WuWingKit/tree-whitewashing-robot/software/README.md

# 上位机与操作界面

底盘测试已提供无需安装的浏览器控制页，由S3托管，见[使用步骤](../firmware/remote_control/README.md)和[网页源码](../firmware/remote_control/esp32/RemoteControl/index.html)。

尚无完整视觉上位机、树干识别或覆盖率算法交付。几何假设与测距边界见[感知设计](../docs/05-perception.md)。
