WuWingKit/tree-whitewashing-robot/reports/2026-11-03/README.md

# 2026-11-03历史阶段汇报

[阶段进度与设计方案（背景配图版）](stage-progress-background-20261103.pptx)保留选题、概念设计和早期汇报内容。

**这是历史文件，不是最新BOM或接线依据。** 其中控制分工、超声波/红外等传感器、选型状态和部分参数可能早于后续采购变更。请以仓库首页、当前设计文档及2026-11-05采购表为准。历史PPT没有经过逐页更新，不应直接作为最终答辩定稿。

PPT含厂商展示图和网络背景图，仅作为原阶段汇报存档；图像不因此获得新的使用授权，见[第三方说明](../../THIRD_PARTY.md)。
