WuWingKit/tree-whitewashing-robot/docs/01-requirements.md

# 项目背景与需求

## 背景与工作范围

城市道路沿线树木的涂白作业需要沿树列逐棵进行。项目希望用移动底盘承载涂料、搅拌与环抱喷涂机构，通过自动识别、停车定位、环抱和垂直升降减少重复人工操作。节省材料、提高效率和减少人员接触属于项目目标，目前没有实测依据，不能宣称已经实现节能或环保收益。

现实设想是在辅道沿树列行进；当前只在自行搭建的缩比场景开展研究。实际道路的行人、路缘石、树池、坡度、路面不平、阳光和水尘条件不在首轮模型验证结论的覆盖范围内。

## 已确认的设计约束

|项目|当前状态|
|---|---|
|底盘|已采购双层大号亚克力四驱差速底盘，12V 320rpm编码器电机SKU|
|底盘尺寸|早期讨论275×192 mm；参考板照片230×305×5 mm。均不能代替当前整车实测轮廓，需测长宽、轮距和轴距|
|承载|用户预计2.5 kg；尚无整车承载试验，须明确是净载荷还是含整车总质量|
|机构位置|车身侧面、固定伸出长度；立柱从下层固定|
|夹爪尺寸|内径100、外径140、高50 mm，6孔；打印后净空另测|
|升降|拟选180 mm行程，17HS4401＋TB6600，尚未采购定型|
|树干模型|直径和间隔尚未定稿；不要求算法预先知道树间距或树径|
|行驶策略|沿树列总体向前，在每棵树前减速调整姿态并停车；不是行驶中喷涂|
|计算位置|电脑处理视觉和任务逻辑，车端完成实时执行与保护|

缩比应以当前实测底盘宽度/拟模拟实际车辆宽度定义比例，实车宽度1～2 m的讨论尚未给出唯一比例。树径、涂白高度、树池与间隔必须使用同一比例；夹爪100 mm和滑台180 mm还需要做空间兼容检查，不能称现有所有尺寸已经严格等比例。

## 首阶段目标与验收思路

完成受控场地内多棵模型树连续作业演示：识别下一棵树、逐步接近、停车并确认对中、检查作业范围、闭合环抱、搅拌供料并升降、停泵、评价可见涂白效果、打开后离开。

评估指标包括对中误差、有效测距率、单树作业时间、可见表面覆盖率、单位作业耗液量、通信丢帧与指令延迟、异常停机成功率。先采集基线再设合适阈值，当前不编造达标数据。

## 优先完成的范围

先完成普通差速底盘低速闭环和作业端近距定位；再解决未知树径下前向距离估计。先以清水检查喷淋和漏液，再用目标涂料验证流变与防堵。声光提示、显示界面和OTA保留接口，不能先于基本动作与断联停止验证。
