WuWingKit/tree-whitewashing-robot/docs/09-procurement.md

# 已采购产品与待选型清单

采购快照截至2026-11-05，依据用户提供的最新订单PDF逐项脱敏转录。已采购指已下单，不代表已收到、已装配或性能通过验收。订单号、账号、地址与支付凭据不进入公开仓库。

详见[机器可读已购表](../hardware/bom/purchased.csv)与[待选表](../hardware/bom/planned.csv)。单价与行金额按订单转录，折扣及四舍五入可能导致数量×显示单价不完全等于行金额。最终合计按行金额相加。

|产品|采购规格|数量|行金额/元|快照状态|
|---|---|---:|---:|---|
|电池及充电器|12V 5000mAh；DC公母头；配1A充电器|1|57.00|待发货|
|ST-LINK V2|进口芯片软件可升级；随机颜色|1|15.53|已发货|
|USB转TTL|CH340小板|1|5.63|已发货|
|USB Hub|灰色Type-C上行；USB3口+Type-C1口|1|10.00|待发货|
|ToF测距模块|TOF050C|3|34.46|已发货|
|USB摄像头|720P 90度无畸变|1|38.00|待发货|
|USB摄像头|720P 70度无畸变|1|36.00|待发货|
|ESP32-S3开发板|N16R8；Type-C；不焊针|1|28.51|已发货|
|STM32核心板|正点原子STM32F407ZGT6；不焊排针|1|88.00|待发货|
|杜邦线|30cm三款120根|1|10.66|已发货|
|杜邦线|15cm三款120根|1|8.21|已发货|
|杜邦线|21cm三款30根|1|4.70|已发货|
|四路电机驱动板|酷点TB6612带稳压4路|1|67.11|已发货|
|四轮差速底盘|双层大号亚克力305系列；12V 320rpm编码电机|1|299.89|已发货|

**14条已购明细合计：703.70元。** 两台相机同一订单合计74元；三款杜邦线合计23.57元。ST-LINK使用订单商品价格15.53元记录，先用后付页面显示的当前支付额不视作零成本。

## 到货特别检查

- 电池最终为DC公母头SKU，替代先前讨论的XH接口版本；充电器1A不表示放电能力。
- 底盘为普通轮四驱差速，非麦轮；305系列属于商品套件名称，实际电机具体型号和电流需核实。
- TOF订单是050C，不是选型图里的050F，三只应确认固件/接口模式。
- S3和F407均为不焊排针版本；本地资料文件夹名称不改变订单SKU。
- Hub为Type-C上行、USB3口＋Type-C1口的商品SKU；下游Type-C是否支持数据以及S3兼容性需检查。
- 摄像头所购为720P70°与90°；商品标题1080P/200万不能覆盖具体SKU。
- 驱动板为酷点四路TB6612，已有接口与稳压功能，但不能直接套用其他品牌的电源额定值或5V输出结论。

## 未计入本次已购金额

180mm滑台及17HS4401/TB6600、ZP15S-C舵机、六只02号80°喷嘴、泵、搅拌电机、供料附件、打印材料、独立功率驱动、急停/限位/保护配电、显示屏与声音模块均未在本次采购PDF中确认。打印连接件、环抱和搅拌模型是制作计划，不等于这些组件已装配完成。

商品规格截图、卖家展示和订单只能证明选型或购买信息，不证明性能达标。后续追加采购应更新CSV和本页，并保留版本日期。
