WuWingKit/tree-whitewashing-robot/THIRD_PARTY.md

# 图片、文档与第三方资料说明

本仓库的设计说明由项目讨论整理。hardware/images中的侧置总成、环抱和搅拌图片来自用户提供的现有CAD截图，不含可编辑制造模型。

历史PPT保留用户用于阶段汇报的商品展示图和网络背景配图，原作者与厂商保留相应权利；这些图不能因仓库公开而推断可独立商业转载。PPT内已有的来源标注随文件保留，若需对外再版，应重新核验配图授权及来源。

商品名称与参数用于记录本次采购和工程核对，不表示厂商为本项目背书。厂商完整电路包、程序、视频、安装工具和订单原件没有上传。官方资料见docs/references.md，引用不转移其版权。

本仓库尚未选择项目开源许可证。第三方资料不适用项目未来可能采用的许可证，后续发布原始CAD或代码前应单独确认授权范围。
