WuWingKit/tree-whitewashing-robot/docs/10-decisions.md

# 设计演变与未决问题

|议题|当前结论|历史候选或仍待解决|
|---|---|---|
|底盘|已购四轮差速普通轮|麦轮45°平移曾讨论，现不采用其横移假设|
|安装位置|车身侧面，立柱从下层固定|早期正面概念图不代表当前结构|
|伸出机构|固定连接件，无主动水平伸缩|此前伸缩定位方案舍弃|
|环抱|舵机＋齿轮两半环开合|需验证最大开度与退出轨迹|
|主控|F407ZGT6＋单块S3 N16R8|F407VET6/P4等讨论非实购基线|
|相机|720P90°前向＋70°作业端|不是两台60°，也不是按标题认定1080P|
|测距|三只TOF050C已购|超声波＋红外为旧方案，050F表不能代替050C手册|
|网络|S3无线转发，F407本地控制|双相机同步高帧率未承诺；分时验证优先|
|电池|5000mAh DC公母头＋1A充电器已购|小容量与XH方案被替代|
|供电|需依据实购酷点板复核|厂商5.3V警告推翻无条件直接供所有5V设备的假设|
|执行器|滑台、舵机、泵、搅拌仍选型|不是全部完成采购|

## 待关闭的主要风险

1. **无法横移的底盘与固定侧臂**：提前接近和姿态调整须沿差速可行曲线完成。必须用实际开爪CAD包络验证前进能否把树引入并退出，不能仅在停车点绘制闭合位置。
2. **重心与承载**：滑台本体、上层液体和侧悬力矩可能先于电控资源成为限制，先称重/计算再定容积。
3. **流量过大**：六只02喷嘴在清水额定压力下总流量偏大，模型可能快速耗液，应单嘴试喷再定泵和分组方式。
4. **网络失联**：电脑不承担硬实时保护；本地超时、限位和急停是必备实现项。
5. **单点测距几何**：到表面距离不能自动得到树心；侧向视场不能直接提前看见任意下一棵树。
6. **安全区域不完整**：两只ToF不是完整安全扫描器，受控场地需现场监督。
7. **USB带宽与兼容性**：Hub外形正确并不等于S3能稳定采两路；需测试后决定是否调整架构。
8. **型号/版本混用**：供应商资料、订单SKU和实物逐项核对，避免把WHEELTEC、酷点、不同S3板版混为一谈。

当前优先完成电源、单轮闭环、单相机和ToF台架，再打印装配与整机。所有后续结论应附对应测试记录。
