WuWingKit/tree-whitewashing-robot/reports/2026-11-03/stage-progress-background-20261103.pptx

树木涂白机器人

方案设计与阶段进度汇报

城市道路行道树侧向环抱作业

2026年11月3日

Notes: 本次汇报介绍城市道路行道树涂白机器人的项目背景、现阶段进度、侧装机械结构、喷涂供料、电气控制与后续验证。项目目前已购买小车，其他部件仍处于候选选型和设计阶段。团队已提供环抱机构、侧装升降总成和搅拌装置的CAD图，连接件与环抱装置采用3D打印制造方案。不得将候选参数、效果目标或概念设计表述为已经实现的性能。

## Slide 2

项目背景与作业场景

城市行道树的逐棵涂白作业，需要重复接近、供料和上下涂刷

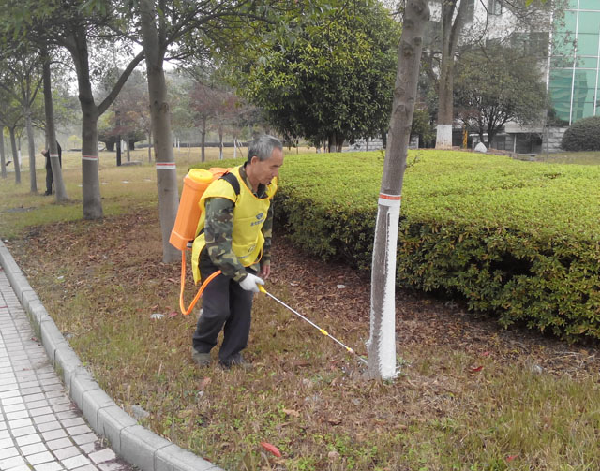
[picture p4: figure]
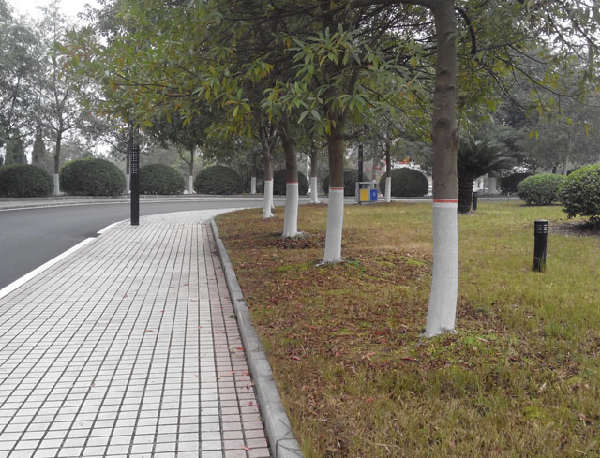
[picture p5: figure]

人工涂白：逐棵操作与携料

研究目标是减少重复操作，并记录漏涂与耗料。

实景图片来源：洪江市人民政府《冬季树木涂白好处多》，2017-01-03。

道路树列：沿线移动与停车

侧装机构需适应路缘、树池和树干位置变化。

02

Notes: 树干涂白属于园林养护作业，但是否需要涂白、适用树种和涂白剂应由养护要求决定，不能笼统宣称对所有树种都有显著防虫和防冻效果。国家林草局的北京调研报道指出，涂白的防护实效具有树种和条件差异。因此，本项目研究重点是机械作业的可控性、覆盖一致性、人工操作负担与涂料损失，而不是证明涂白剂的生物学效果。真实作业存在路缘石、树池、行人车辆及局部路面不平，首版先在自建模拟场地验证。

资料来源
国家林草局 北京科学精准开展树干涂白 https://www.forestry.gov.cn/c/www/stcjslcs/656555.jhtml
北京市养护采购技术资料 对避免漏刷与流撒提出要求 https://swj.beijing.gov.cn/zwgk/zfcg/zbcjgg/202004/P020200427686159549667.pdf

新增网络实景图来源（用于展示养护场景，不代表本项目样机或测试结果）：
洪江市人民政府《冬季树木涂白好处多》，2017-01-03。网页未单列摄影者。
https://www.hjs.gov.cn/hjs/c123599/201701/18a9eec841c04939857bf8918821e0ad.shtml
人工操作图：https://www.hjs.gov.cn/hjs/c123599/201701/18a9eec841c04939857bf8918821e0ad/images/731b5cded4754e9b81284e0379fc00ab.jpg
道路树列图：https://www.hjs.gov.cn/hjs/c123599/201701/18a9eec841c04939857bf8918821e0ad/images/11518a23c2a747f59a21ebde11dd057c.jpg

## Slide 3

侧向作业场景示意

俯视示意：小车在辅道沿树列前进，停车后由车侧机构环抱树干

已完成的树

当前作业树

下一棵树

树池带

路缘

环抱装置位于车侧

停车对中后闭合，滑台带动装置升降。

固定侧向连接件

小车

前进方向

辅道

接近并定位

停车、环抱与升降涂白

张开退出后继续前进

方案示意，非比例图。实际进入、退出轨迹及路缘跨越空间需在模型场地验证。

03

Notes: 本页为根据团队方案绘制的可编辑俯视示意图，不是道路实测地图，也不是整机比例装配图。小车长轴沿树列方向，环抱装置位于小车侧面，固定侧向连接件连接竖直滑台的滑块。图中车轮只表示底盘位置，不指定最终轮型。树木间距、树径以及车与树的距离均未按比例绘制。机器人需要在接近阶段完成横向与角度修正，停车复核后才闭合环抱。固定侧装机构能否只通过前进完成进入、退出，取决于最大开口、树干净空、固定伸出长度和车体转向能力，需经过扫掠包络与实物测试，图中前进箭头仅表示总体行进方向。路缘与树池会限制车侧接近，应记录高度、宽度和立柱安装位置，不能把平整模型测试直接等同于真实道路可用。
来源：团队方案说明，本页原创结构关系示意。实景背景参见前一页洪江市人民政府报道。

## Slide 4

当前进度

已完成选题与总体方案收敛，小车已购，其余部件继续选型

工作项 | 目前状态 | 本阶段成果或边界
作业场景与目标 | 已明确 | 沿道路树列前进，停车侧向作业
小车底盘 | 已购买 | 拟用12 V、320 RPM编码电机，参数复核
环抱与连接结构 | 已有CAD方案 | 确定3D打印路线，打印完成状态待确认
滑台、供料和传感 | 候选选型 | 型号与配套能力尚未锁定
整机装配与测试 | 后续开展 | 暂无效率、覆盖率与耗料实测结论

04

Notes: 本页严格区分实际进度和拟用方案。用户已确认小车购买完成，其他部件尚未完成选型。最新提供的喷头、齿轮、夹爪和舵机资料用于收敛候选规格，不能据此认为已采购或完成装配。连接件和环抱装置按3D打印方式制造，但尚未明确是否已经完成打印。下一步的实际交付物应包括装配尺寸图、候选物料清单、供电与驱动匹配表，以及分模块测试记录。

资料来源
资料来源 团队本轮说明及所附CAD和商品参数图

## Slide 5

侧装总体结构

夹爪安装在车侧，固定长度连接件与升降滑块连接

底盘下层承载立柱

立柱根部直接连接下层底板，连接板与背板共同分散受力。

滑块带动整套刷头升降

固定连接件承载舵机、齿轮和半环，不设置主动水平伸缩。

车辆定位承担横向对中

开合空间、侧向外廓与退出轨迹需一起校核。

05

Notes: 侧装是本方案的明确约束。车头沿道路行进，环抱装置沿车体宽度方向伸向树木，不能将它解释成前置夹爪。立柱固定在底盘下层，不让上层料箱平台单独承担刷头悬臂载荷。载荷路径为刷头、连接件、滑块和导向、立柱根部、底盘。固定连接件不增加主动伸缩轴，但可以评估少量弹性或被动浮动来吸收树干偏心。CAD图表达结构方案，不等于整机完成装配，也不提供经过验证的承载数据。

资料来源
团队最新侧装CAD图 assets/side_assembly.png

## Slide 6

双层底盘布局

下层集中电控与电池，上层布置搅拌装置和泵

下层：电池与控制板

电池低位固定，电机驱动、ESP32和滑台驱动分区安装，保留保险与总开关。

上层：矮料箱与供料部件

搅拌桶靠近车体中心，泵便于拆洗。设置接液盘，液路避开下层电控。

底板图示230×305毫米、厚5毫米。最终装配尺寸以实购底盘测量为准。

06

Notes: 本轮底板图标注230×305 mm、厚5 mm，与前期讨论的275×192 mm小车外形不同，应分别记录底板尺寸、含轮外形、轴距和轮距，不混用。两层之间使用刚性立柱连接，上层料箱采用矮而宽的形式并尽量靠近车辆中心，避免把液体重心抬得过高。亚克力板在立柱根部应使用大垫片或背板分散压力，避免在开槽或孔边形成集中载荷。满载、空载和最高升降位置均应检查稳定性。总搭载重量需重新称量，不能沿用未核实的2.5 kg额定载荷。

资料来源
团队底板图片 assets/baseplate.jpg

## Slide 7

分离式环抱装置

固定长度侧装，舵机通过齿轮使两片半环对称开合

内径100 mm

外径140毫米，高50毫米，六个喷头孔位。有效净空需扣除喷嘴与刷毛侵入。

每半环布置3个喷头

管路分成左右两支，铰接处留软管余量，闭合接缝防止形成漏涂带。

大环口提供容纳空间，柔性刷条负责贴合树皮。

07

Notes: 本轮结构尺寸以团队提供的内径100 mm、外径140 mm、高50 mm为准，替换前期建议的90 mm内径。六孔应对应六喷头，每半环三孔，孔位须结合实际喷嘴螺纹图重新确认。大环口并不能自动保证小树干得到涂刷，建议采用可更换分段刷条，评估弹性刷座及少量被动浮动。刚性净空、有效刷毛接触范围和定位容差分别测量。内径尺寸必须说明是裸环内径还是扣除喷嘴和刷条后的净空。喷嘴、紧固件与接头不应在开合过程中碰撞树干或相邻部件。

资料来源
团队环抱CAD图及最新尺寸说明

## Slide 8

齿轮与舵机开合设计

最新候选舵机为众灵ZP15S-C，单轴15KG级磁编码总线舵机

齿轮：模数1，40齿

齿厚30毫米。两只同齿数外啮合齿轮按1∶1反向同步，初装角决定实际开口。

供电与协议需单独确认

图片标注5至12伏、360°。支持串口并兼容PWM，舵机使用独立供电支路。

铰轴承担结构载荷，舵机输出轴仅负责传动。

08

Notes: 本页用最新ZP15S-C资料替换早期未明确型号的10KG舵机。图片中的15KG是扭矩等级宣传，不能解读为夹爪能承载15 kg，额定或堵转力矩、测试电压、连续工作能力及峰值电流仍需向厂家确认。360°标注也不能代替串口协议和实际位置控制范围。标准模数1、40齿直齿轮的分度圆直径为40 mm，实际齿形、压力角、中心距和齿隙应按CAD及打印结果核对。30 mm齿厚会增加重量和摩擦，可在不改变功能的情况下评估减重。齿轮两端需要可靠轴向限位及独立轴承或衬套，不以舵机轴承承受全部悬臂力矩。

资料来源
团队最新众灵舵机型号表 assets/servo_zp15sc.png
团队给定齿轮参数 模数1 40齿 厚30 mm

## Slide 9

180 mm行程侧装升降

候选采用17HS4401步进电机与TB6600驱动

提升对象

滑块、连接件、环抱机构、舵机及活动管线。料箱和电池留在底盘。

选型检查

确认导程、自重、竖直载荷和偏载能力，配置回零与上下限位。

标称行程180毫米，实际覆盖取决于限位余量、毛刷宽度及最低工作位置。

09

Notes: 滑台目前属于候选部件，尚未确认已购。侧装夹爪形成偏心力矩，导向结构需要承受弯矩，丝杆负责轴向驱动。17HS4401常见保持扭矩不能直接当作所有转速下的可用扭矩，更不能直接换算为整机载重。需要取得实际电机铭牌、丝杆导程及滑台受力数据。TB6600相电流按实际电机与驱动器峰值或有效值定义设置，从低速加减速调试开始。开机先回零，不碰机械终点；失电时不允许非受控下落。配线和供料软管应留升降弯曲余量，并限制拖拽刷头。

资料来源
团队滑台照片 assets/slide.jpg
电机厂家参考目录 https://motionking.com/download/HB_Stepper_Motor_E.pdf
TB6600模块资料 https://wiki.dfrobot.com/dri0043

## Slide 10

3D打印搅拌与料箱

搅拌装置模型已形成，驱动电机和密封结构仍需选型

搅拌桨靠近桶底

低速持续或间歇搅拌，减少沉降。桨叶避开桶底和桶壁，不形成明显飞溅。

湿区部件便于拆洗

桶盖可拆，轴与盖设置支承及防溅结构。泵吸入口避免直接吸取底部沉积。

3D打印模型不等于可靠液密容器，需验证渗漏与涂料相容性。

10

Notes: 搅拌装置采用团队给出的四叶桨模型进行3D打印实现。第一版应优先验证低速混合与清洗，而不是追求高转速。打印料箱和桨叶的层间孔隙、耐碱性及磨损必须通过实际涂料浸泡与运行试验确认，必要时采用现成密闭料箱搭配打印盖和桨架。轴承及电机放在桶盖干区，避免让电机轴直接承担全部搅拌轴支承。桶体上增加液位标记和可拆排放口，设置接液盘及电控隔离。搅拌电机需要独立驱动通道，不占用已经用于四个车轮的四路驱动接口。

资料来源
团队搅拌CAD图 assets/mixer.png

## Slide 11

六喷头与分配管路

当前候选为02号、80°扇形、1/4直通喷嘴

六个喷头分成两组

每半环三个，使用分配歧管与尽量一致的支路，预留单支路流量检查。

扇面方向需通过试验确定

先比较润湿刷毛与直接喷树两种状态，控制重叠、流挂和接缝漏涂。

80°为喷角，不是全周覆盖保证；1/4接头孔位按实际螺纹图加工。

11

Notes: 最新喷头候选信息为02号、80°扇形、1/4直通，数量六个。早期直径10 mm、长度23 mm属于此前外形描述，不能作为最新1/4螺纹的加工依据，必须取得供应商尺寸与接口图。提供的流量表02行还列出约0.91 mm喷孔，外形直径、连接螺纹和喷孔直径是不同参数。喷头可优先对着柔性刷条供料以减少飞散，但实际喷角受压力、浆料性质及喷距影响，需要台架试验。80°喷角不等于环抱装置自动获得360°均匀覆盖。喷嘴与管接头不能侵入必要净空，也不能在开合时拉扯管线。

资料来源
团队喷头图片 assets/nozzle.jpg
团队喷嘴参数与流量表 assets/nozzle_flow.jpg

## Slide 12

喷头流量与泵的匹配

六喷头连续出料量较大，泵暂定，先完成供料台架测试

压力 | 单喷头标称流量 | 六喷头合计
1 bar | 0.46 L/min | 2.76 L/min
2 bar | 0.64 L/min | 3.84 L/min
3 bar | 0.79 L/min | 4.74 L/min

表中为标称流量，实际浆料流量需另行测试。

选泵依据

先确认工作压力和目标耗料，再比较脉冲供料、分组出料或更小流量喷嘴。

12

Notes: 流量计算依据团队提供的供应商表。02行在0.5 bar一列未给数值，不能误将0.46读成0.5 bar流量。1 bar为0.46 L/min，2 bar为0.64 L/min，3 bar为0.79 L/min；分别乘六得到2.76、3.84、4.74 L/min。表格未说明测试介质，本页仅按标称值估算，实际涂料流量、黏度、颗粒和沉降影响必须实测。较大的连续流量可能与模型料箱和2.5 kg搭载预算冲突，不能直接据此购买大泵。先确定每次作业目标耗料、实际压力和供料方式，再定泵。若采用脉冲或分组，需验证喷型和均匀性；如果流量仍过大，调整喷嘴是合理的候选优化。液路需有适配泵的调压或回流保护、可拆洗过滤和清洗接口。

资料来源
团队喷嘴流量截图 assets/nozzle_flow.jpg；六喷头合计为本汇报计算

## Slide 13

树干定位与传感器分工

传感器位于环抱装置上方，视野避开喷头和运动半环

视觉传感器

识别树干左右轮廓和中心方向，判断是否接近夹爪中心线。

未知树径时，普通单目不能独立确定绝对距离。

超声波传感器

提供距离门限与接近反馈，辅助车辆低速停车，异常回波时停止接近。

需验证近距盲区、细圆柱回波，以及树池和背景造成的误测。

同一台摄像头可分时承担定位与效果采集，是否复用取决于视场、近焦和污染测试。

13

Notes: 本轮用户指定使用视觉与超声波，本页保留这一候选路线，不擅自替换为此前讨论的ToF。相机可定位树干轮廓并估计对中方向，但未知树径时不能仅从一张普通图像得出绝对距离。超声波测的是有效回波对应的表面距离，不能直接称为树干几何中心距离，也不能保证斜前方回波一定来自下一棵树。需结合视觉目标关联和近距离测试。对细圆柱，回波强度、角度和背景都重要，传感器不能仅凭量程选型。安装在活动平台上时，应标定升降位置与相机姿态，并为进入、退出设置固定的定位高度。必要时把测距升级列为后续优化，不作为现阶段已实现功能。

资料来源
超声波厂家关于目标尺寸与波束的说明 https://maxbotix.com/blogs/blog/reading-beam-patterns
相机投影说明 https://dev.realsenseai.com/docs/projection-in-realsense-sdk-2-0/

## Slide 14

单树作业流程

车辆沿树列前进，接近阶段完成距离与姿态调整

01

寻找并低速接近

识别下一棵树，确认有效距离，提前减速并调整车辆姿态。

02

停车后复核对中

车辆停止，距离与前后偏差进入机械允许范围。

03

环抱与供料准备

确认半环张开空间，低速闭合到位，启动搅拌并准备供料。

04

升降完成涂白

供料与升降联动，遇限位、卡阻或测量异常立即停止相关动作。

05

停泵并采集效果

待余料稳定后拍摄，记录可见区域覆盖与明显漏涂。

06

张开并退出树干

确认机构脱离树干且路径无干涉，再前往下一棵树。

14

Notes: 此流程为拟实施状态机，不代表已经自动运行。小车原则上沿道路向前推进，但普通轮、麦轮或阿克曼的最终运动方式尚需按实购底盘确认，不能把45°平移当作所有底盘都具备的动作。固定侧装环抱机构没有主动伸缩，底盘必须在闭合前完成主要位置修正。退出动作和进入动作需要共同规划，尤其不能在刷环仍包围树干时直接转动车体。如果既定只前进路径无法避开树干，需调整开口方向、连接件布置或行驶轨迹。环抱是使柔性刷毛贴合，不是夹紧树干承受整车载荷。

## Slide 15

底盘电机与四路驱动

小车已购，电机按12 V、320 RPM编码电机的拟用参数复核

四轮独立驱动

每个车轮具有独立驱动通道和编码器测速，建立本地轮速闭环。

型号名称需要对照实物

团队描述为305系列，图示支持型号列出310等，需核对轴径、插头和编码器定义。

转速320转/分钟，车速及载荷另行核算。

15

Notes: 小车购买完成，但不能从电机系列名称推断全部参数。用户本轮描述为12 V、320 RPM、305系列编码电机，需与实物铭牌核对，确认320 RPM是空载还是额定工作转速，并补充轮径、额定电流、启动和堵转电流、编码器电压与每转计数。给出的电机板图片同时包含双驱和四驱版本，实际需要四路独立车轮驱动的版本。若为四轮差速，也可按运动学分配轮速，但编码反馈仍应可读取。增加编码器主要用于稳定轮速和估计短时位移，最终对树位置仍由外部感知确认。TB6612板上的稳压不代表它能给四路电机提供恒定12 V。

资料来源
团队驱动板图片 assets/driver.jpg
TB6612FNG原厂数据手册 https://toshiba.semicon-storage.com/info/TB6612FNG_datasheet_en_20141001.pdf?did=10660&prodName=TB6612FNG

## Slide 16

电源与驱动匹配

TB6612适配与否取决于电流和供电瞬态，不能只比较12 V标称值

2.5–13.5 V

TB6612FNG电机侧推荐工作电压范围

1.2 A / 3.2 A

每通道平均与单脉冲电流上限，不能作为持续工作能力承诺

01

驱动按实测电流选

校核电机带载、启动和堵转条件及板级散热，必要时改用更大电流驱动。

车轮与泵电源、舵机电源、逻辑电源分支供电，分别保护，并验证启动压降。

16

Notes: TB6612FNG数据手册给出的VM推荐工作范围为2.5至13.5 V，15 V是绝对最大值，不能用作正常工作电压。每通道1.2 A平均和3.2 A峰值也位于绝对最大额定值表，3.2 A仅对应10 ms单脉冲条件，运行范围及热条件更加严格。选型应留出裕量，不应直接按1.2 A连续满载设计。当前不知道305编码电机的堵转电流，因此不能确认此驱动板合适。电源也要按电池满充电压而非仅按12 V名称核对。车轮四通道、搅拌、泵、舵机和TB6600分别核算，逻辑降压电源不能承担舵机和泵启动电流。信号侧按ESP32的3.3 V电平核对，编码器和超声波若输出更高电平应作接口转换。

资料来源
Toshiba TB6612FNG Operating Range及Absolute Maximum Ratings https://toshiba.semicon-storage.com/info/TB6612FNG_datasheet_en_20141001.pdf?did=10660&prodName=TB6612FNG

## Slide 17

ESP32与电脑的计算分工

建议电脑先完成感知计算，ESP32保留必要的实时控制

设备 | 承担任务 | 数据与输出
电脑上位机 | 树干识别、位置估计、覆盖分析 | 接收图像与遥测，发送目标速度和作业指令
ESP32 | 轮速闭环、脉冲与舵机控制、联锁 | 读取编码器和限位，执行并反馈状态
云端 | 后续记录、统计与非实时分析 | 上传图像与日志，不直接控制单次电机脉冲

建议补充：ESP32不做视觉重计算，但不能只做数据转发。

17

Notes: 团队原思路是ESP32不做计算，把数据发到云端或电脑后接收指令。这里建议保留不在ESP32进行视觉重计算的目标，同时让ESP32承担不可省略的本地控制。轮速闭环、步进脉冲、限位、急停和断联处理依赖短时确定性，不宜通过公网逐次下发。首版采用电脑上位机连接ESP32，云端仅作为可选日志和离线分析路径，以减少网络和相机接口变量。USB工业相机可以直接接电脑，ESP32不一定能接任意USB或网口工业相机；若后续要求车载无线视频，再按具体ESP32型号、相机接口、分辨率和带宽选型。普通ESP32与ESP32-S3的USB能力不同，不可混用结论。

资料来源
Espressif PCNT编码器计数 https://docs.espressif.com/projects/esp-idf/en/stable/esp32/api-reference/peripherals/pcnt.html
Espressif USB相机方案 https://docs.espressif.com/projects/esp-techpedia/en/latest/esp-friends/solution-introduction/camera/usb-camera-solution.html

## Slide 18

通信协议与本地联锁

控制指令带有效期，执行结果返回确认，异常状态在车端处理

上传遥测

时间戳、序号、四轮计数、测距及有效标志、限位状态、电池电压和当前作业状态。

下发指令

目标车速或轮速、升降目标、夹爪开合、泵与搅拌开关，并包含指令序号和有效期。

断联或测距无效

停止接近并停泵，升降保持受控状态，等待人工恢复。

限位或卡阻

本地停止相关轴，记录故障，禁止未经确认自动继续。

18

Notes: 通信建议采用有明确帧格式和校验的协议。起步可用USB串口，后续切换局域网时保留相同消息语义。指令应带序号、时间戳或有效期，拒绝过期和重复执行的危险动作。上位机发送目标速度和目标状态，不连续传每个PWM或步进脉冲。遥测需区分有效测距与超时，不把无回波解释为距离为零。通信超时时限根据实测速度与停车距离设置，不能套用一个未经试验的固定值。开合需要实际到位确认，不能仅认为发送角度就已经到位。急停和限位不依赖云端返回。固件保留看门狗和人工恢复逻辑，防止程序异常后继续出料。

资料来源
Espressif Watchdogs https://docs.espressif.com/projects/esp-idf/en/latest/esp32/api-reference/system/wdts.html

## Slide 19

色块分析与涂白效果评价

定位与作业后拍摄分时进行，先评价相机可见区域

01

建立有效树干区域

分割树干，排除背景、夹爪遮挡、喷头和强反光区域。

02

统计白色覆盖与漏涂

在固定曝光、白平衡和补光条件下，比较阈值分割与人工标注。

03

保留作业记录

保存作业前后图像、可见区域覆盖率及人工复核结果。

19

Notes: 建议用色彩空间阈值和连通区域先做可解释的基础算法，而不直接追求复杂模型。覆盖率定义为当前图像内判定已涂白的有效树干像素占有效树干像素的比例。喷涂过程中雾滴、湿亮表面和机构遮挡会改变判断，因此在停泵、余料稳定后采集效果图。阈值需要用实际树皮和涂料样本标定，不能认为只要颜色接近白色就属于合格涂层。单视角结果不能代表树干全周，也不能推断涂层厚度、附着力或生物学效果。首版补涂由人工确认后触发，待评价误差可控后再讨论自动补刷。优先用同一台摄像头分时复用，减少重量与成本。

## Slide 20

关键参数与待确认事项

最新资料已收敛部分规格，采购前仍需完成接口与载荷核对

模块 | 当前拟用参数 | 仍需确认
环抱与齿轮 | 内径100、外径140、高50毫米 齿轮模数1、40齿、厚30毫米 | 喷嘴侵入、开合净空、刷毛范围与打印误差
喷嘴与供料 | 6个02号80°扇形，1/4直通 | 接口图、喷距、工作压力、浆料流量与泵
舵机 | ZP15S-C 单轴15KG级 360° | 额定力矩、峰值电流、协议与限位
底盘与驱动 | 小车已购；12 V/320 RPM拟用 | 305型号、轮型、编码器及TB6612电流匹配
滑台与主控 | 行程180毫米 17HS4401/TB6600、ESP32 | 导程、自重、偏载、接口及供电预算

20

Notes: 所有当前拟用参数均为团队最新讨论内容，不等于已采购规格。小车已购，其他模块需在装配设计和试验后最终锁定。喷头早期10 mm外形与最新1/4接口信息不能直接合并加工；喷嘴0.91 mm孔径来自供应商表，还需确认02规格实际交货。主控保留ESP32系列，但具体开发板型号应结合GPIO、硬件计数、通信和相机接口选择。传感器、泵、搅拌驱动和电源容量尚未定型。下一阶段需要形成版本一致的物料清单和接口表，避免各模块按不同资料采购。

## Slide 21

分模块验证计划

先完成干运行与清水测试，再使用实际涂料进行联合验证

验证对象 | 主要检查 | 形成的记录
打印件与开合 | 孔位、齿隙、铰轴、有效净空、软管避让 | 尺寸表、开合视频与修改项
升降与侧装 | 偏载升降、最高位稳定、限位与断电保持 | 载荷条件、速度、温升和异常记录
供料与搅拌 | 六支路流量、沉降、堵塞、停机重启与清洗 | 压力、耗料、漏液和喷涂照片
定位与整车 | 不同树径和偏移下停车、环抱及退出 | 定位误差、闭合成功率与单树用时
图像与通信 | 人工标注对比、断联、旧指令和无效测距 | 算法误差、日志与本地保护结果

21

Notes: 测试先明确条件和记录方法，再制定合格阈值。开合不带涂料先验证碰撞与退出空间，清水用于检查密封和基础流量，但不能代表浆料相容性。实际涂料测试需分别记录料箱重量变化、地面滴漏和树干覆盖情况，不能把出料量全部算成有效用量。定位容差应从有效环口、最大树径、刷毛压缩和打印间隙推导，不能直接沿用前期15 mm建议。模拟树径和横向位置可以变化，但不把每棵树的实际直径和间距预置到算法。覆盖率只评价规定视角，再用人工多角度复核。重复试验次数、目标速度及验收阈值由首轮结果确认，当前没有已达标数据。

## Slide 22

下一阶段工作安排

按接口确认、试制、分系统验证和整机联调推进

01

完成选型与接口冻结

取得电机、滑台、舵机和喷嘴正式参数，核算重量、电流及供料需求。

02

完成打印与机械装配

制作连接件和半环，检查侧装受力、开合净空、齿轮同步与管线布置。

03

完成独立模块调试

先调轮速、升降和开合，再调搅拌与供料，建立电脑与ESP32通信。

04

完成模型场地联调

逐棵验证接近、停车、涂白、评估和退出，按记录修改方案。

22

Notes: 此处采用依赖关系安排工作，不虚构团队尚未确认的具体周次和采购日期。首先完成参数收敛，尤其确认TB6612电流裕量、泵与六喷头流量矛盾、超声波在细模型树干上的有效回波。然后完成3D打印和装配，建立可重复的机械零位。软件从本地人工触发开始，再接入上位机识别与状态切换，最后验证逐棵作业。每个阶段保留可审查的尺寸、照片、视频和测试记录，遇到接口或受力问题及时更新同一版本的物料清单和装配图。

## Slide 23

阶段成果与近期交付

当前已购小车，侧装环抱总体方案已形成，后续重点是配套选型与验证

本阶段已经明确

双层底盘与车侧立柱
固定长度连接件与齿轮环抱
六喷头供料及3D打印搅拌方案
电脑感知与ESP32执行的分工

下一阶段需要交付

统一版本的尺寸与物料清单
电源、驱动和供料匹配结果
打印件装配及分模块测试记录
单树作业循环的实测视频

目标：在模拟场地实现可重复的侧向环抱涂白作业。

23

Notes: 结束时重申当前进度和实际研究目标。我们已经完成选题和结构路线收敛，小车已购，已获得可用于设计的CAD与候选部件资料。其他部件尚未全部完成选型和采购，整机性能尚待验证。下一阶段围绕侧装机械可靠性、六喷头供料量、驱动电流、近距定位以及本地联锁开展试验。所谓快速作业，应以实际单树循环时间、人工干预次数和覆盖记录证明，现阶段不报未经测量的效率提升百分比。模型场地验证通过后，再讨论真实道路的行驶、环境适应与作业组织。
