WuWingKit/tree-whitewashing-robot/hardware/bom/purchased.csv

记录ID | 产品 | 采购SKU | 数量_套或件 | 订单显示单价_元 | 行金额_元 | 店铺 | 订单快照状态_2026-11-05 | 核对备注
P001 | 电池及充电器 | 12V 5000mAh；DC公母头；配1A充电器 | 1 | 57.00 | 57.00 | 鸿锐翔电子有限公司 | 待发货 | 放电能力及极性待验
P002 | ST-LINK V2 | 进口芯片软件可升级；随机颜色 | 1 | 15.53 | 15.53 | risym旗舰店 | 已发货 | 调试下载；价格非当前支付额
P003 | USB转TTL | CH340小板 | 1 | 5.63 | 5.63 | telesky旗舰店 | 已发货 | 电平和跳线待验
P004 | USB Hub | 灰色Type-C上行；USB3口+Type-C1口 | 1 | 10.00 | 10.00 | 艾莱克旗舰店 | 待发货 | 下游Type-C数据能力及S3兼容性待验
P005 | ToF测距模块 | TOF050C | 3 | 11.49 | 34.46 | zave旗舰店 | 已发货 | 行金额含订单折扣；非050F
P006 | USB摄像头 | 720P 90度无畸变 | 1 | 38.00 | 38.00 | SHUNCCM舜鑫工业旗舰店 | 待发货 | 前向；UVC格式和视场定义待验
P007 | USB摄像头 | 720P 70度无畸变 | 1 | 36.00 | 36.00 | SHUNCCM舜鑫工业旗舰店 | 待发货 | 作业端；近距对焦待验
P008 | ESP32-S3开发板 | N16R8；Type-C；不焊针 | 1 | 28.51 | 28.51 | zave旗舰店 | 已发货 | 16MB Flash/8MB PSRAM；原生USB供电待验
P009 | STM32核心板 | 正点原子STM32F407ZGT6；不焊排针 | 1 | 88.00 | 88.00 | 正点原子旗舰店 | 待发货 | 需焊接排针并核对板版本
P010 | 杜邦线 | 30cm三款120根 | 1 | 10.66 | 10.66 | touglesy旗舰店 | 已发货 | 仅信号/适合电流用途；非大电流线
P011 | 杜邦线 | 15cm三款120根 | 1 | 8.21 | 8.21 | touglesy旗舰店 | 已发货 | 按套记录
P012 | 杜邦线 | 21cm三款30根 | 1 | 4.70 | 4.70 | touglesy旗舰店 | 已发货 | 按套记录
P013 | 四路电机驱动板 | 酷点TB6612带稳压4路 | 1 | 67.11 | 67.11 | 酷点智能科技 | 已发货 | 5V口约5.3V厂商警告；电机电流匹配待验
P014 | 四轮差速底盘 | 双层大号亚克力305系列；12V 320rpm编码电机 | 1 | 299.89 | 299.89 | 酷点智能科技 | 已发货 | 普通轮；实际尺寸和电机型号待验
