WuWingKit/tree-whitewashing-robot/firmware/remote_control/WIRING.md

# TB6612—STM32F407—ESP32-S3接线表

适用本次程序：正点原子F407ZGT6最小系统板、ESP32-S3 N16R8、酷点MD04四路TB6612、普通轮四驱差速底盘。以下按引脚**丝印名称**接线，不按照片中的左右位置猜排针。首次四轮架空、低占空比测试。

## 1. 电源：先独立供电，再共地

|来源|接到|说明|
|---|---|---|
|12V电池DC公头|TB6612的12V DC输入|核对5.5×2.1尺寸和正负极；供电不超过厂商规定13V|
|电脑USB或经确认的5V USB电源|F407板上USB转串口供电口|本程序不依赖板上CH340串口，USB线可仅用于供电；实际板型插口以实物为准|
|电脑USB或经确认的5V USB电源|S3板USB转UART口|下载和串口日志都走此口；不接原生USB相机口|
|TB6612 GND|F407 GND|必须接|
|S3 GND|F407 GND|必须接，三板信号共地|

**本次不接TB板的5V输出到两块开发板。** 实购厂家注意事项称其约5.3V且有外设损坏警告。先使用USB稳定供电；无线落地时可用经过确认的5V电源/移动电源给两板USB供电。所有执行电流走驱动板电池支路，不经过杜邦信号线。

两板各自有USB供电时，不再把两板5V/3.3V引脚互连，也不要把USB5V与其他5V输出直接并联。不允许12V直接接S3的5V/3V3、F407的3V3或任意GPIO。

## 2. STM32与ESP32：115200，8N1，3.3V TTL

|ESP32-S3|STM32F407|方向|
|---|---|---|
|GPIO17，UART1 TX|PA3，USART2 RX|ESP32发给STM32|
|GPIO18，UART1 RX|PA2，USART2 TX|STM32状态返回ESP32|
|GND|GND|信号参考地|

TX与RX交叉。不要接RS232电平，不用USB转TTL模块夹在两板之间。GPIO19/20留原生USB，GPIO35/36/37不占用。

## 3. 四轮与驱动板编号

从车上往行驶正前方看，定义如下，并将电机六针插头插到相应驱动通道：

```text
                 车头 / 前进方向 ↑
          左前 M1              右前 M3
          左后 M2              右后 M4
```

M1～M4均为程序约定，可重新插电机到对应接口；不假定原车出厂编号和此图相同。每个电机接**对应六针编码电机接口**，不要把两针普通电机口和六针编码口重复并联接。

## 4. TB6612控制线：共12根信号＋地

|驱动通道/车轮|TB板丝印|F407引脚|用途|
|---|---|---|---|
|M1 左前|1P|PE9|TIM1_CH1，20kHz PWM|
|M1 左前|1IN1|PG11|方向普通GPIO|
|M1 左前|1IN2|PG12|方向普通GPIO|
|M2 左后|2P|PE11|TIM1_CH2，20kHz PWM|
|M2 左后|2IN1|PG13|方向普通GPIO|
|M2 左后|2IN2|PF8|方向普通GPIO|
|M3 右前|3P|PE13|TIM1_CH3，20kHz PWM|
|M3 右前|3IN1|PD3|方向普通GPIO|
|M3 右前|3IN2|PD6|方向普通GPIO|
|M4 右后|4P|PE14|TIM1_CH4，20kHz PWM|
|M4 右后|4IN1|PD7|方向普通GPIO|
|M4 右后|4IN2|PE2|方向普通GPIO|
|公共地|GND|GND|必须共地|

厂家接线PDF中M3的PWM有一处误写成4P；本程序M3接实物**3P**，M4接4P。没有对外确认的STBY口，本次不用PG15接STBY，也不要求自行焊芯片引脚。

**只有1P～4P接PWM；所有IN1/IN2均是稳定高低电平。** 对可能复位/拔线时悬空的控制线，应核实板上输入默认下拉；必要时在PWM输入各加10kΩ到GND，避免把固件当作上电前的硬件保护。断电/软件停止不代表车辆瞬间物理静止。

## 5. 编码器：本版不需要接到STM32

第一版按照厂家“先开环、后闭环”的顺序验证，编码器AB输出引脚暂时悬空、不接F407；四轮六针电机线仍可正常连接到驱动板。本版网页没有实测速度，不做PID，不用错误编码器方向导致闭环失控。

后续确认AB电平后可按原资源计划接TIM2/3/4/8；未经确认，不把驱动板输出的5V编码器信号直接接入所有MCU脚。

## 6. 可选本地停车按钮

PE0接常开按钮一端，另一端接GND；按下为低电平，程序立即取消启用并清零输出。松开后必须重新点击网页“启用遥控”。未装按钮时内部上拉使其处于允许状态。

这个输入只是软件停车测试接口，**不是断线检测型安全急停**，也不能替代电池支路可触及的总开关。当前程序没有接入ToF或相机自动避障。

## 7. ST-LINK接线与板载资源

ST-LINK SWDIO→PA13，SWCLK→PA14，GND→GND；需要时NRST→NRST。板子通过USB独立供电；廉价ST-LINK的“3.3V”常是电源输出，本次不接，避免重复供电。若使用正规的VTref输入型调试器，则按其说明接参考电压。

保持正常Flash启动的BOOT跳线。程序不启用FSMC、外部SRAM、LCD、摄像头接口；PG10作为板载SRAM片选固定拉高，避免PE9/11/13/14与SRAM数据线冲突。烧入的是本程序，不能同时运行厂商全外设演示。HSE按本地F407模板的8MHz配置。

## 8. 首次核对轮向

`stm32/App/board_config.h`默认左轮SIGN=+1、右轮SIGN=-1，仅表示对称安装的初始假设，**不保证实物电机线序一定匹配**。先把`MOTOR_ENABLE_MASK`设为0x01，依次测试0x02、0x04、0x08，确认每轮“前进”转向，再恢复0x0f。某一轮反转时只改对应`MOTORn_SIGN`并重新编译烧录；不要随意对调六针编码器线。

如果直接使用现成HEX，可先断开电机电源，只插一路电机到其对应通道，架空测试后断电更换下一路。四路方向均确认后再全部接齐；不要带电插拔六针线。现成HEX默认启用全部四路。

如果20%架空仍不转，先核对电池、地、PWM和方向信号，不要直接拉满占空比或用手卡轮。实际电机电流与TB6612匹配仍需验证。
