WuWingKit/tree-whitewashing-robot/docs/08-validation.md

# 验证计划与下一阶段

## 阶段状态

|阶段|状态|交付要求|
|---|---|---|
|选题与总体设计|已完成首版|当前设计文档与历史演变|
|底盘/控制/部分传感采购|已下单|见采购表，未统一确认收货|
|机械详细设计|进行中|干涉、强度、安装与制造图|
|执行系统选型|未完成|滑台、舵机、泵、搅拌与配电|
|固件/上位机|已增加开环遥控测试版，整机未交付|见[遥控测试](../firmware/remote_control/README.md)；闭环、喷涂与视觉仍待开发|
|整机装配与连续作业|未验证|下述逐级测试记录|

## 顺序与验收记录

1. **到货核对**：拍摄板号/接口，测整车轮廓、轮径、轴距、轮距和质量；逐项核对SKU及附件，登记实收数量。不公开快递标签。
2. **电源台架**：核对电池/充电器和极性；实测TB板所谓5V输出；先确认目标板输入范围，再接电控。记录空载、摄像头采集和无线发送时电压/电流/温升。
3. **F407基础**：焊排针、SWD烧录、串口、硬件急停输入。检查禁用SRAM后引脚不冲突。
4. **单轮到四轮**：架空低占空比测试方向、编码器A/B和每圈计数；落地低速闭环，限制加速度，记录启动/转弯电流与驱动温升。发现明显超限先整改，不能用长时间堵转测试验证。
5. **ToF**：独立测试近距到最大实际需求，改变树模型颜色、直径、倾角和照明；记录有效率与误差，再接三只检查地址/串扰。
6. **USB相机**：先接电脑查UVC格式和近焦；S3先单机，后Hub双机枚举与分时采集。记录分辨率、帧率、延迟、丢帧、5V电流和掉线恢复，而不是只看能显示一帧。
7. **并发通信**：同时上传视频/ToF状态和下发控制，主动断开网络/重启S3/停止心跳，确认F407按设计停止危险动作。
8. **机械台架**：打印装配、开合干涉、滑台限位回零、侧悬偏载与掉电行为；无涂料验证夹爪开口和退出轨迹。
9. **液路**：先清水单喷头，测压力与流量、喷形和防滴，再六嘴；检查泵、软管、过滤、密封和目标涂料防堵。完成试验后清洗。
10. **整机模型**：先单树、再多树，不向算法预置树间距/树径；改变树模型位置和直径，统计入位误差、干涉、覆盖率、耗液量和作业时间。

## 必须补齐或确认的部件

- 急停、保险、主开关、额定足够的配电连接器与线材；经验证的控制5V供电方案。
- 滑台和驱动、上下限位；舵机、独立支承轴/轴承、到位反馈。
- 泵、搅拌电机、各自驱动、软管/接头/过滤/调压或回流/密封件。
- 板卡排针焊接、固定与防溅外壳；S3 USB Host转接/供电路径和Hub兼容性确认。
- ToF三机连接方案；屏幕/扬声器为后续功能，尚未采购。

## 记录模板

每次试验登记日期、硬件版本、固件commit、测试布置、变量、原始数据、异常和结论；区分“通过”“失败”“未测”。当前所有性能数字均为商品参数、设计值或估算，仓库尚无实测性能报告。
