WuWingKit/tree-whitewashing-robot/CHANGELOG.md

# 变更记录

## 2026-11-09：ESP32网页OTA与硬件验证

- 新增独立密码、维护会话、停车联锁、S3应用校验、SHA256、双槽激活和启动确认。
- 实机完成USB初始化、真实无线切槽、错误包/令牌/校验值拒绝、TCP中断处理。
- 确认STM32 UART在线且升级后保持停车；新增操作说明与本地校验清单生成工具。
- STM32 IAP未实现；速度范围保持10%～30%，硬上限35%。

## 2026-11-08：底盘无线遥控测试

- 根据本地酷点、正点原子F407和S3示例资料编写开环遥控程序与接线表。
- 新增电脑浏览器操作、S3热点与串口桥接、F407四路20kHz PWM。
- 新增指令租约、显式启用、超时停车、换向缓冲与软件停车输入。
- 提供本地依赖准备、Keil工程生成、编译和主机测试脚本；上车性能尚未验证。

## 2026-11-05：首次公开项目快照

- 汇总侧置固定连接件、双半环齿轮开合、竖直滑台与双层底盘方案。
- 以最新订单脱敏建立14条已购明细，合计703.70元。
- 当前控制基线更新为F407ZGT6＋单块S3 N16R8；感知为两台720P相机与三只TOF050C。
- 明确普通差速底盘不能横移、树皮距离不等于树心、双相机通过S3需要验证。
- 按实购酷点附送资料记录5V接口约5.3V警告及原理图5V/3A标注，不沿用其他品牌电源结论。
- 保留11月3日历史汇报，未将旧PPT当作当前采购或实现状态。
- 尚无整机测试报告和自研固件/上位机交付。
