WuWingKit/tree-whitewashing-robot/(commit log)

2026-11-05 docs: publish robot design baseline and sanitized procurement snapshot
    [planned.csv, purchased.csv]
2026-11-08 feat: add tested Wi-Fi teleoperation for ESP32-S3 and STM32F407
2026-11-09 feat: add authenticated ESP32 web OTA with hardware-verified stop interlocks
